PWRJOY/drain-diverter/images/1c0c867001f6781cb55c42ae2e2e353.jpg

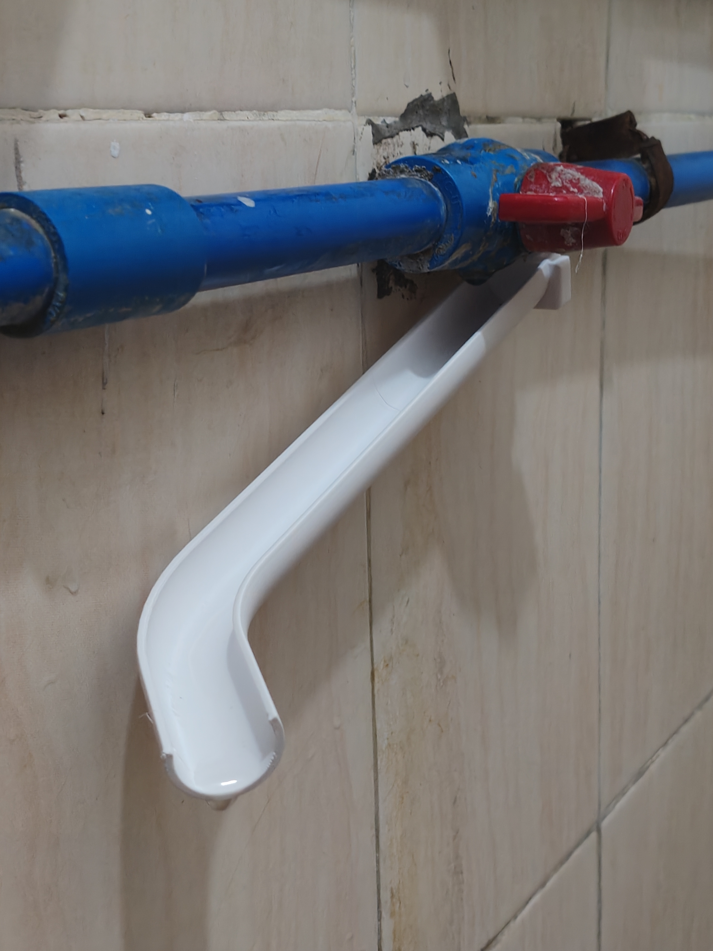
images/1c0c867001f6781cb55c42ae2e2e353.jpg
