PWRJOY/drain-diverter/images/7058d763eb84ac824557cdff8fdf2e0.jpg

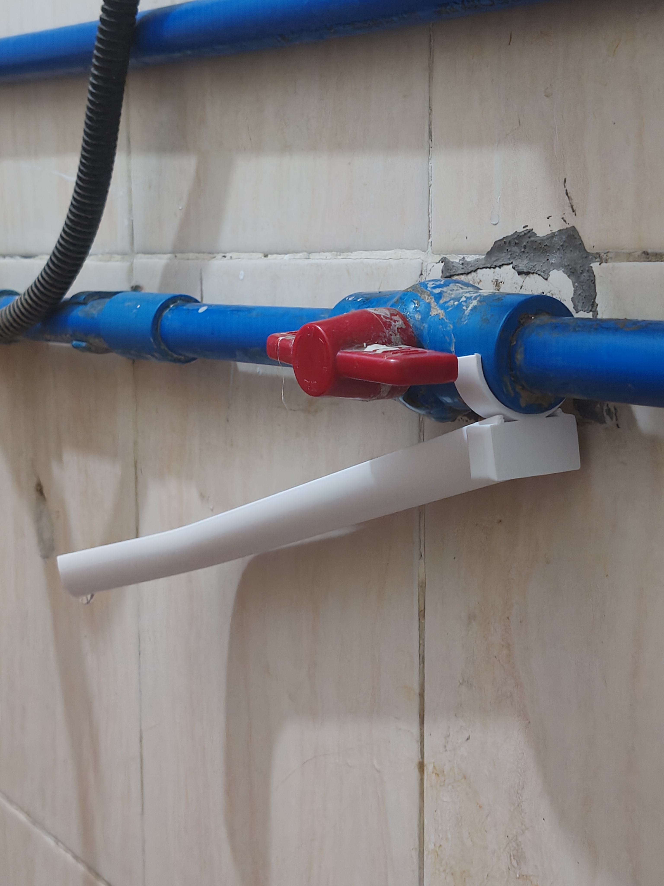
images/7058d763eb84ac824557cdff8fdf2e0.jpg
