PWRJOY/drain-diverter/images/ceed48b091ac0753f602a431d6a7a23.jpg

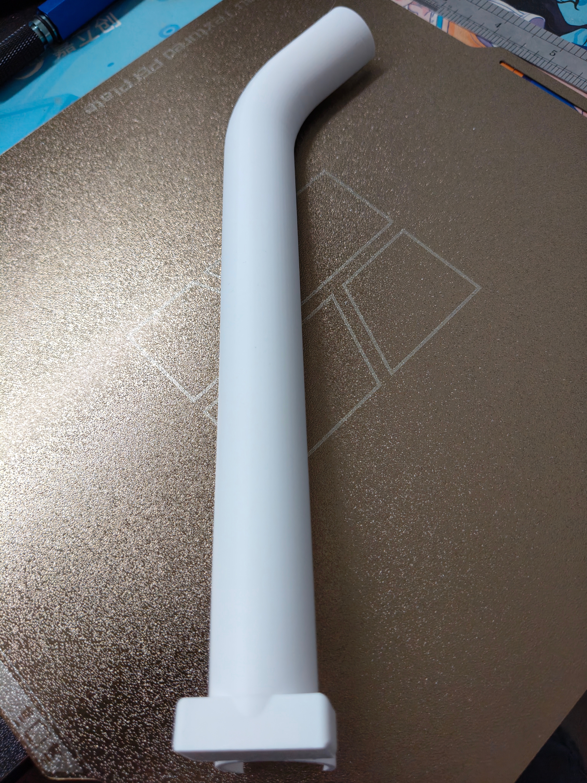
images/ceed48b091ac0753f602a431d6a7a23.jpg
