PWRJOY/drain-diverter/original/引流V1.0-20260913.STL

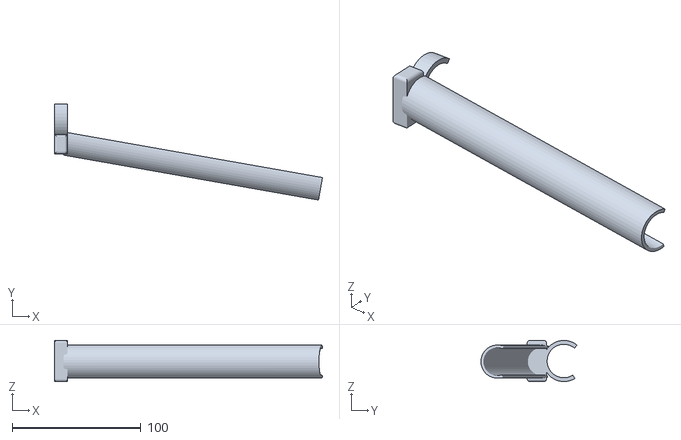
[picture p5: CAD file, 2026-11-02]
original/引流V1.0-20260913.STL
208.1 x 74.6 x 32.0
