PWRJOY/drain-diverter/output/V1.1/引流V1.1-build123d.step

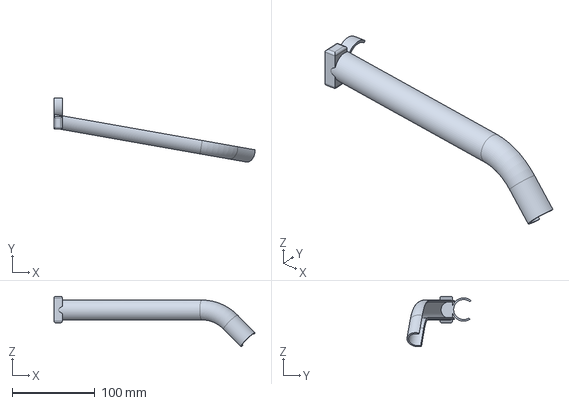
[picture p6: CAD file, 2026-11-02]
output/V1.1/引流V1.1-build123d.step
242.3 x 77.4 x 60.8 mm
