PWRJOY/drain-diverter/original/引流.SLDPRT

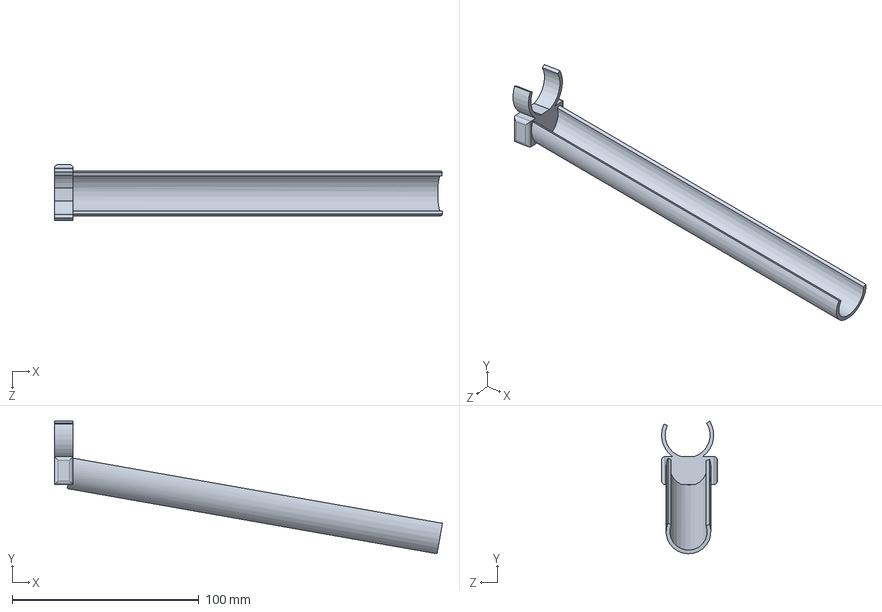
[picture p7: CAD file, 2026-11-02]
original/引流.SLDPRT
207.7 x 71.0 x 30.0 mm
