PWRJOY/drain-diverter/(list of files, cad)

Other CAD files:
output/V1.0/引流V1.0-build123d.step
output/V1.0/引流V1.0-build123d.stl
output/V1.1/引流V1.1-build123d.stl
