PWRJOY/drain-diverter/(commit log)

2026-11-02 docs: 添加水管漏水引流器项目的完整代码和文档
    [引流.SLDPRT, 引流V1.0-20260913.STL, 引流V1.0-build123d.step, 引流V1.0-build123d.stl, 引流V1.1-build123d.step, 引流V1.1-build123d.stl]
2026-11-02 docs: 项目名统一为 Drain Diverter
2026-11-07 docs: 添加三张实物安装照片
